BenW0/IMC-Axis-Simple/pcb/IMC Simple Stepper.pdf

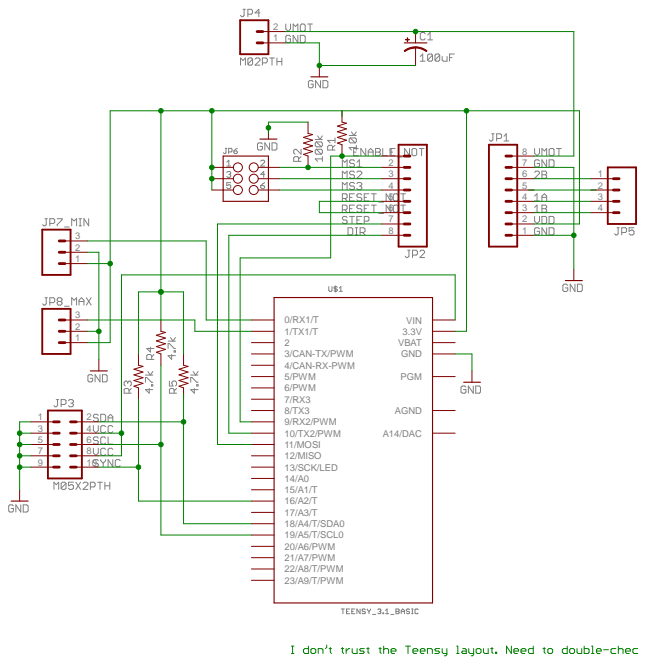
[picture p4: page 1]
12/MISO; 11/MOSI; 10/TX2/PWM; 9/RX2/PWM; 6/PWM; 5/PWM; 4/CAN-RX-PWM; 3/CAN-TX/PWM 2; GND; AGND; 23/A9/T/PWM; 22/A8/T/PWM; 21/A7/PWM; 20/A6/PWM; 19/A5/T/SCL0; 18/A4/T/SDA0; 13/SCK/LED; PGM; VBAT; A14/DAC; VIN
