BenW0/IMC-Axis-Simple/pcb/schematic.sch

## EAGLE design pcb/schematic.sch (2014-08-09)

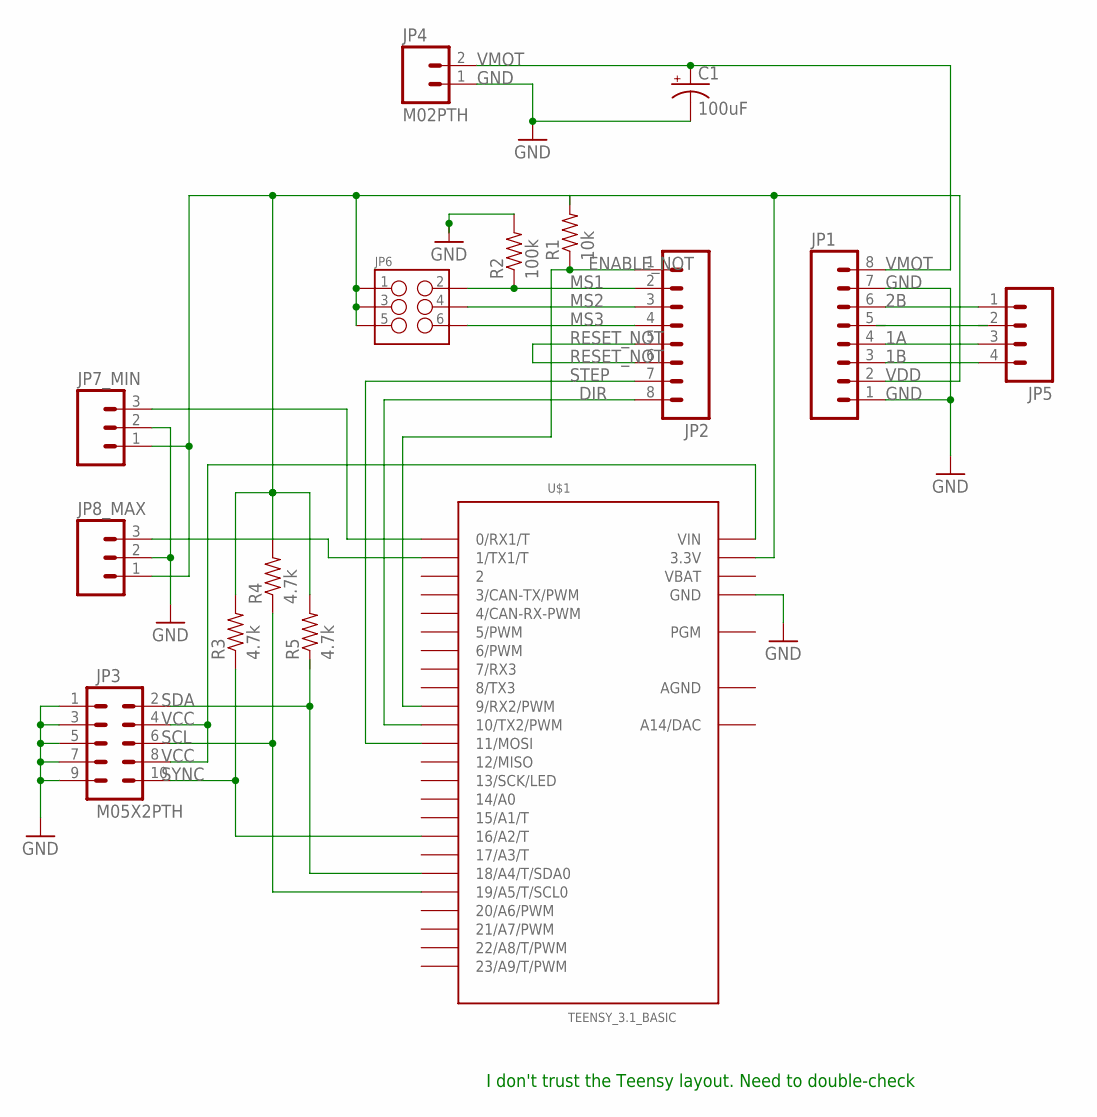
[picture p5: schematic schematic.sch]

Parts:
C1: 100uF; PANASONIC_H13
JP1, JP2: M08; 1X08_PIN1_NO_SILK
JP3: M05X2PTH; AVR_ICSP
JP4: M02PTH; 1X02
JP5: M04PTH; 1X04
JP6: M03X22X3_SILK_SM; 2X3
JP7_MIN, JP8_MAX: M03PTH; 1X03
R1: 10k; AXIAL-0.4
R2: 100k; AXIAL-0.4
R3, R4, R5: 4.7k; AXIAL-0.4
U$1: TEENSY_3.1_BASIC

Connections:
1A: JP1.4, JP5.3
1B: JP1.3, JP5.4
2B: JP1.6, JP5.1
DIR: JP2.8, U$1.10 (10/TX2/PWM)
ENABLE_NOT: JP2.1, R1.P$1 (1), U$1.9 (9/RX2/PWM)
GND: C1.-, JP1.1, JP1.7, JP3.1, JP3.3, JP3.5, JP3.7, JP3.9, JP4.1, JP7_MIN.2, JP8_MAX.2, R2.P$2 (2), U$1.GND
MS1: JP2.2, JP6.2, R2.P$1 (1)
MS2: JP2.3, JP6.4
MS3: JP2.4, JP6.6
unnamed: JP6.1, JP6.3, JP6.5, JP7_MIN.1, JP8_MAX.1, R1.P$2 (2), R3.P$2 (2), R4.P$2 (2), R5.P$2 (2)
unnamed: JP7_MIN.3, U$1.0 (0/RX1/T)
unnamed: JP8_MAX.3, U$1.1 (1/TX1/T)
RESET_NOT: JP2.5, JP2.6
SCL: JP3.6, R4.P$1 (1), U$1.19/A5 (19/A5/T/SCL0)
SDA: JP3.2, U$1.18/A4 (18/A4/T/SDA0)
STEP: JP2.7, U$1.11 (11/MOSI)
SYNC: JP3.10, R3.P$1 (1), U$1.16/A2 (16/A2/T)
VCC: JP3.4, JP3.8, U$1.VIN
VDD: JP1.2, U$1.3.3V
VMOT: C1.+, JP1.8, JP4.2

Notes on the sheet:
I don't trust the Teensy layout. Need to double-check
