BenW0/IMC-Axis-Simple/main.c

#include "parser.h"
#include "queue.h"
#include "protocol/constants.h"
#include "protocol/message_structs.h"
#include "hardware.h"
#include "parameters.h"
#include "stepper.h"
#include "control_isr.h"
#include "config.h"
#include "peripheral.h"
#include "homing.h"
#include <usb_serial.h>
#include <mk20dx128.h>
#include <pin_config.h>

int main(void){
  configure_nvic();
  initialize_i2c(I2C_BASE_ADDRESS + read_i2c_address());
  // Configure all of the hardware and internal state
  initialize_motion_queue();
  initialize_parser();
  reset_parameters();
  initialize_stepper_state();
  set_microstepping(DEFAULT_MICROSTEPPING);
  reset_hardware();
  float_sync_line();
  while(1){
    if(parser.status == PARSER_ERR){
      send_response(IMC_RSP_UNKNOWN,0);
      initialize_parser();
      continue;
    }
    if(parser.status == PARSER_NEW_EVENT){
      switch(parser.packet_type){
      case IMC_MSG_INITIALIZE:
	initialize_motion_queue();
	initialize_parser();
	// Unlike out first initialization round, don't reset parameters
	initialize_stepper_state();
	float_sync_line();
 	response.init.slave_hw_ver = 0;
	response.init.slave_fw_ver = 0;
	response.init.queue_depth = MOTION_QUEUE_LENGTH;
	send_response(IMC_RSP_OK,sizeof(rsp_initialize_t));
	break;
      case IMC_MSG_GETPARAM:
	handle_get_parameter(&parser.packet.get_param, &response.param);
	send_response(IMC_RSP_OK,sizeof(rsp_get_param_t));
	break;
      case IMC_MSG_SETPARAM:
	handle_set_parameter(&parser.packet.set_param);
	send_response(IMC_RSP_OK,0);
	break;	
      case IMC_MSG_QUEUEMOVE:
	{
	  int space = enqueue_block(&parser.packet.move);
	  send_response(space < 0 ? IMC_RSP_QUEUEFULL : IMC_RSP_OK,0);
	  // If we're adding moves in idle state, make sure that the sync interface is listening
	  if(st.state == STATE_IDLE)
	    enable_sync_interrupt();
	}
	break;
      case IMC_MSG_STATUS:
	response.status.queued_moves = queue_length();
	if(st.state == STATE_ERROR){
	  response.status.status = parameters.error_low;
	}else{
	  response.status.status = IMC_ERR_NONE;
	}
	send_response(IMC_RSP_OK,sizeof(rsp_status_t));
	break;
      case IMC_MSG_HOME:
	send_response(IMC_RSP_OK,0);
	enter_homing_routine();
	break;
      case IMC_MSG_QUICKSTOP:
	send_response(IMC_RSP_ERROR,0);
	break;
      }
      initialize_parser();
    }
  }
}
