BenW0/IMC-Axis-Simple/(commit log)

2014-01-29 Added I2C test code.
2014-02-05 Implemented test code for relaying messages to the slave thru the master, including host python module.
    * Some changes to message_structs.h and constants.h in protocol - Matt, we should talk about these
    * Since I wrote the test code in Arduino, message_structs and constants.ha re now repeated in the master_transmitter_test folder.
    * It all builds, but none of it has been tested.
2014-02-20 Pin definitions; pin initializations
2014-02-20 Change units for feedrates and accelerations for compatibility with the existing grbl stepper routines. May change some back, or not
2014-02-20 Clean compile of stepper feeding from a modified queue type
2014-02-20 Random syntax error killing
    [constants.h]
2014-02-21 Basic sync sorta working? Implemented most of the timers etc, but ended up commenting that out for debuging. Next step is restoring full functionality
2014-02-21 Fixed type error on rsp_status_t structure.
    [message_structs.h]
2014-02-27 Switch to using a macro for message count
2014-02-27 Change the limit pin configuration path. Turns out to be significantly more complex that one would think
2014-02-27 Actually return a proper initialization packet, and fix a problem with the device going into reset because of limit ISR firing upon boot. Silly me...
    [hardware.c, main.c]
2014-02-27 That's the bug! Wow, that was obvious and so easy to overlook
    [parameters.c, stepper.c, stepper.h]
2014-02-27 Change pins so that limit doesn't conflict with i2c0
    [hardware.h]
2014-02-28 Working i2c slave code, just taken from original teensy core and de-c++ified
2014-02-28 at the very least, receive i2c data
2014-02-28 executing moves from the i2c interface
2014-03-03 Updated imc_response_type enum so 0 is an error. See Bug 1
    [constants.h]
2014-03-05 State of the slave code as of Monday end of meeting - stil debuging. Also changed homing protocol - no response, but instead a new parameter
2014-03-05 Remove all compile errors about ignoring volatile - probably overkill, but easy enough. Also, be more careful about the state of the sync line
    [main.c, parameters.c, stepper.c]
2014-03-07 Move i2c driver into the parser itself
2014-03-07 Implement subdividing long packets into two, and reseting the parser at the begining of every other transmission
    [main.c, message_structs.h]
2014-03-07 Non-integrated implementation of i2c address selection and run-time microstepping control
2014-03-07 Integrate the i2c address and microstepping code
2014-03-12 Changes from debugging homing
2014-03-12 Prioritize interrupts
2014-06-22 (probable) fix for bug in which flat velocity profiles are executed at an very high speed
    [stepper.c]
2014-08-09 Added PCB files.
    [schematic.sch]
2014-08-09 Added IMC Framework description document.
2014-08-09 Bug fix.
    Sometimes in my testing when entering the sync state the sync line goes high
    and triggers the sync line interrupt before the PIT2 counter starts counting down
    for timeout. As a result, the PIT2 timer is mis-configured and the sync line
    isn't pulled low during the move.
    [stepper.c]
